InterstitialTech/automato-sensor/kicad/automato-jsts.png

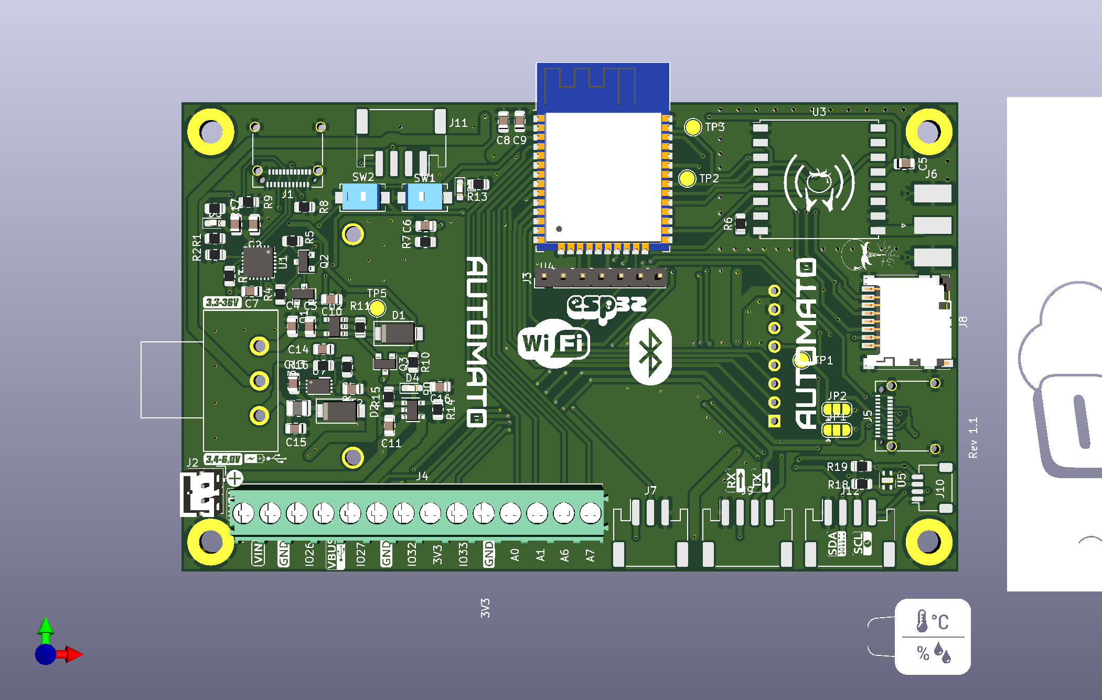
kicad/automato-jsts.png
