InterstitialTech/automato-sensor/README.md

# automato-sensor
sensor module for the Automato ecosystem

Schematic

PCB Layout

3D Rendering
