InterstitialTech/automato-sensor/kicad/automato.kicad_pcb

## KiCad design kicad/automato.kicad_pcb (2022-09-19)

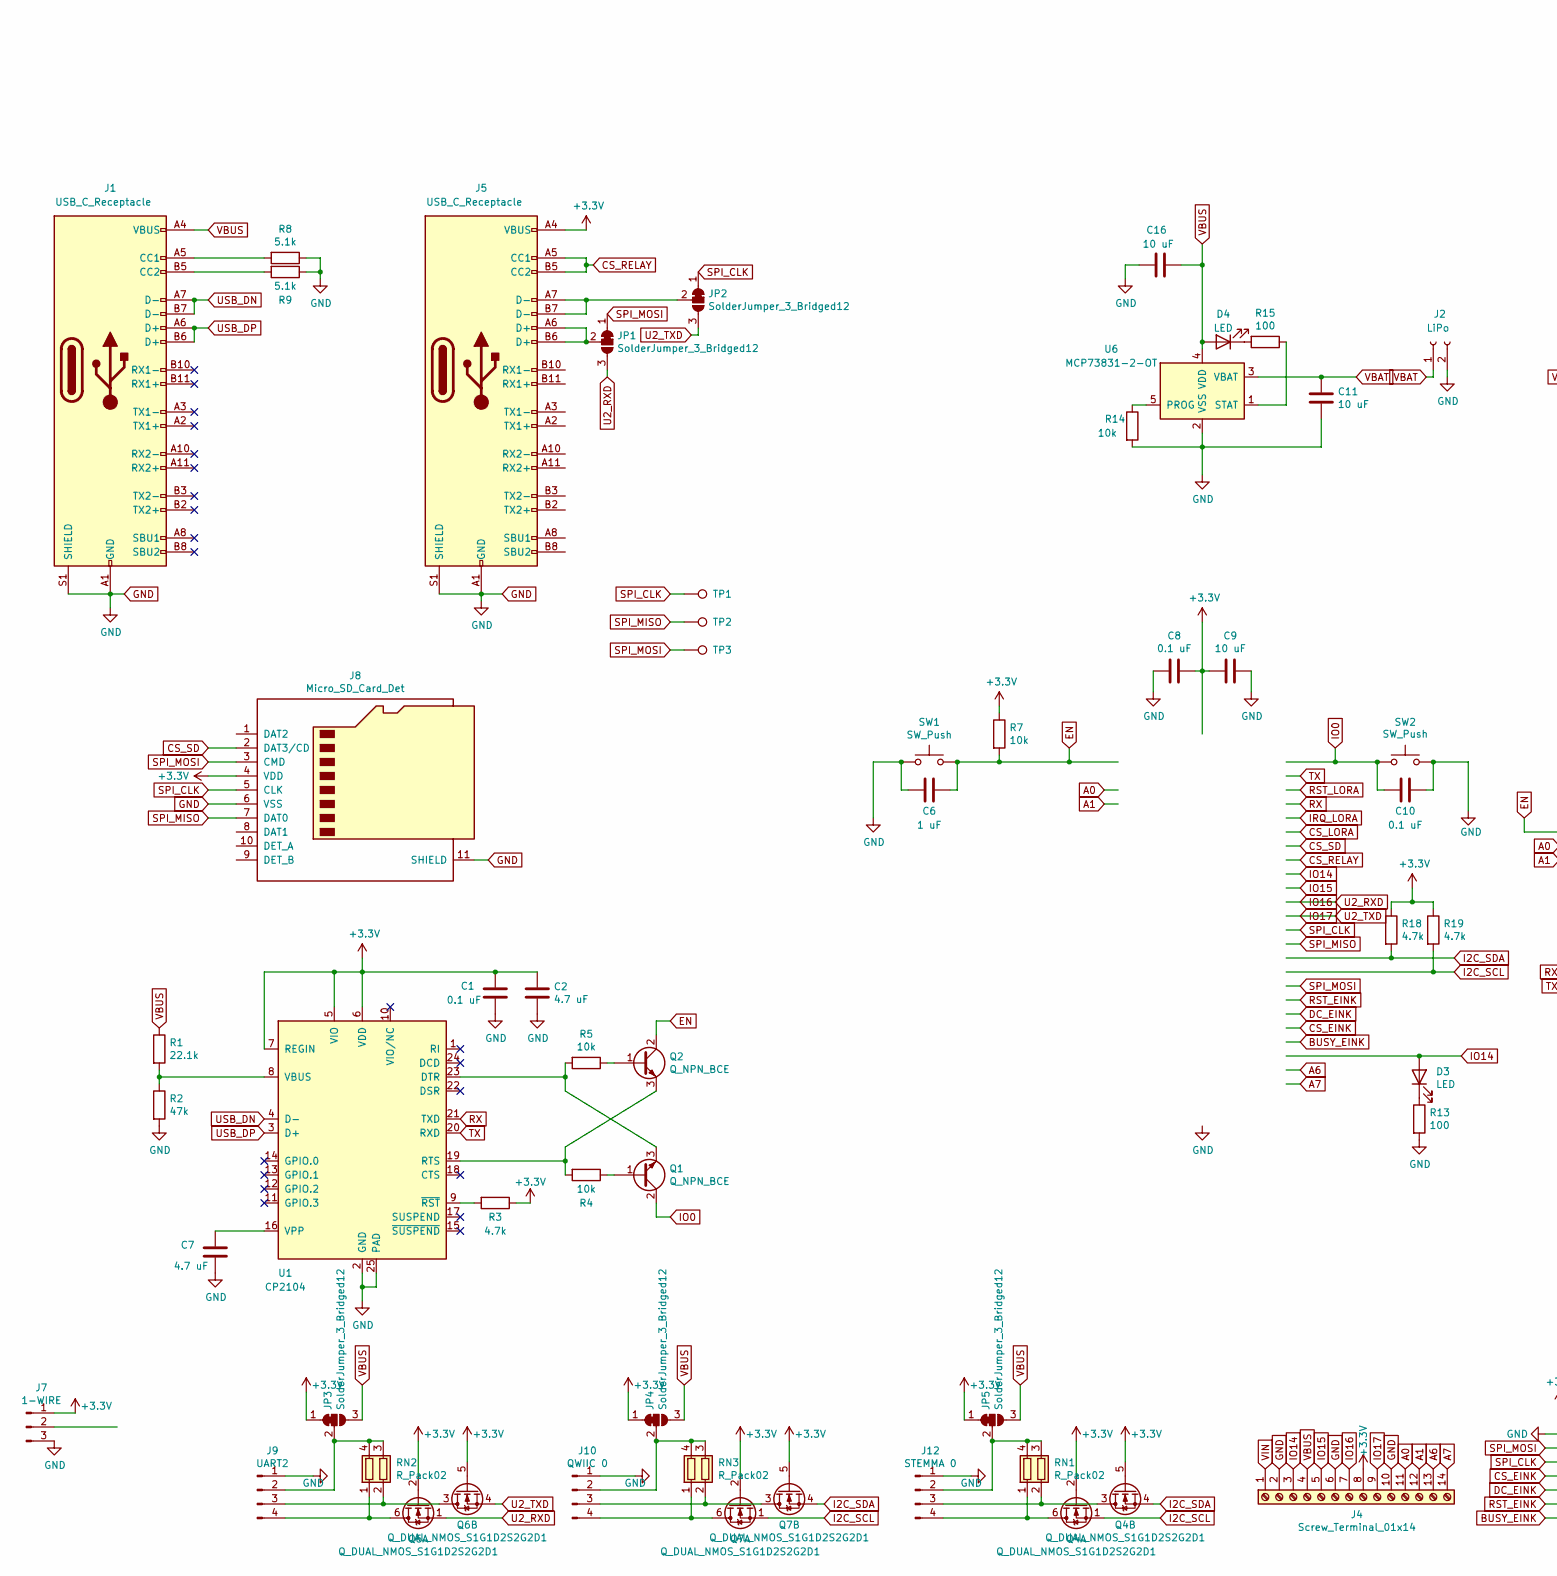
[picture p2: schematic automato.sch, Automato Sensor Board, part in row 1, column 1]

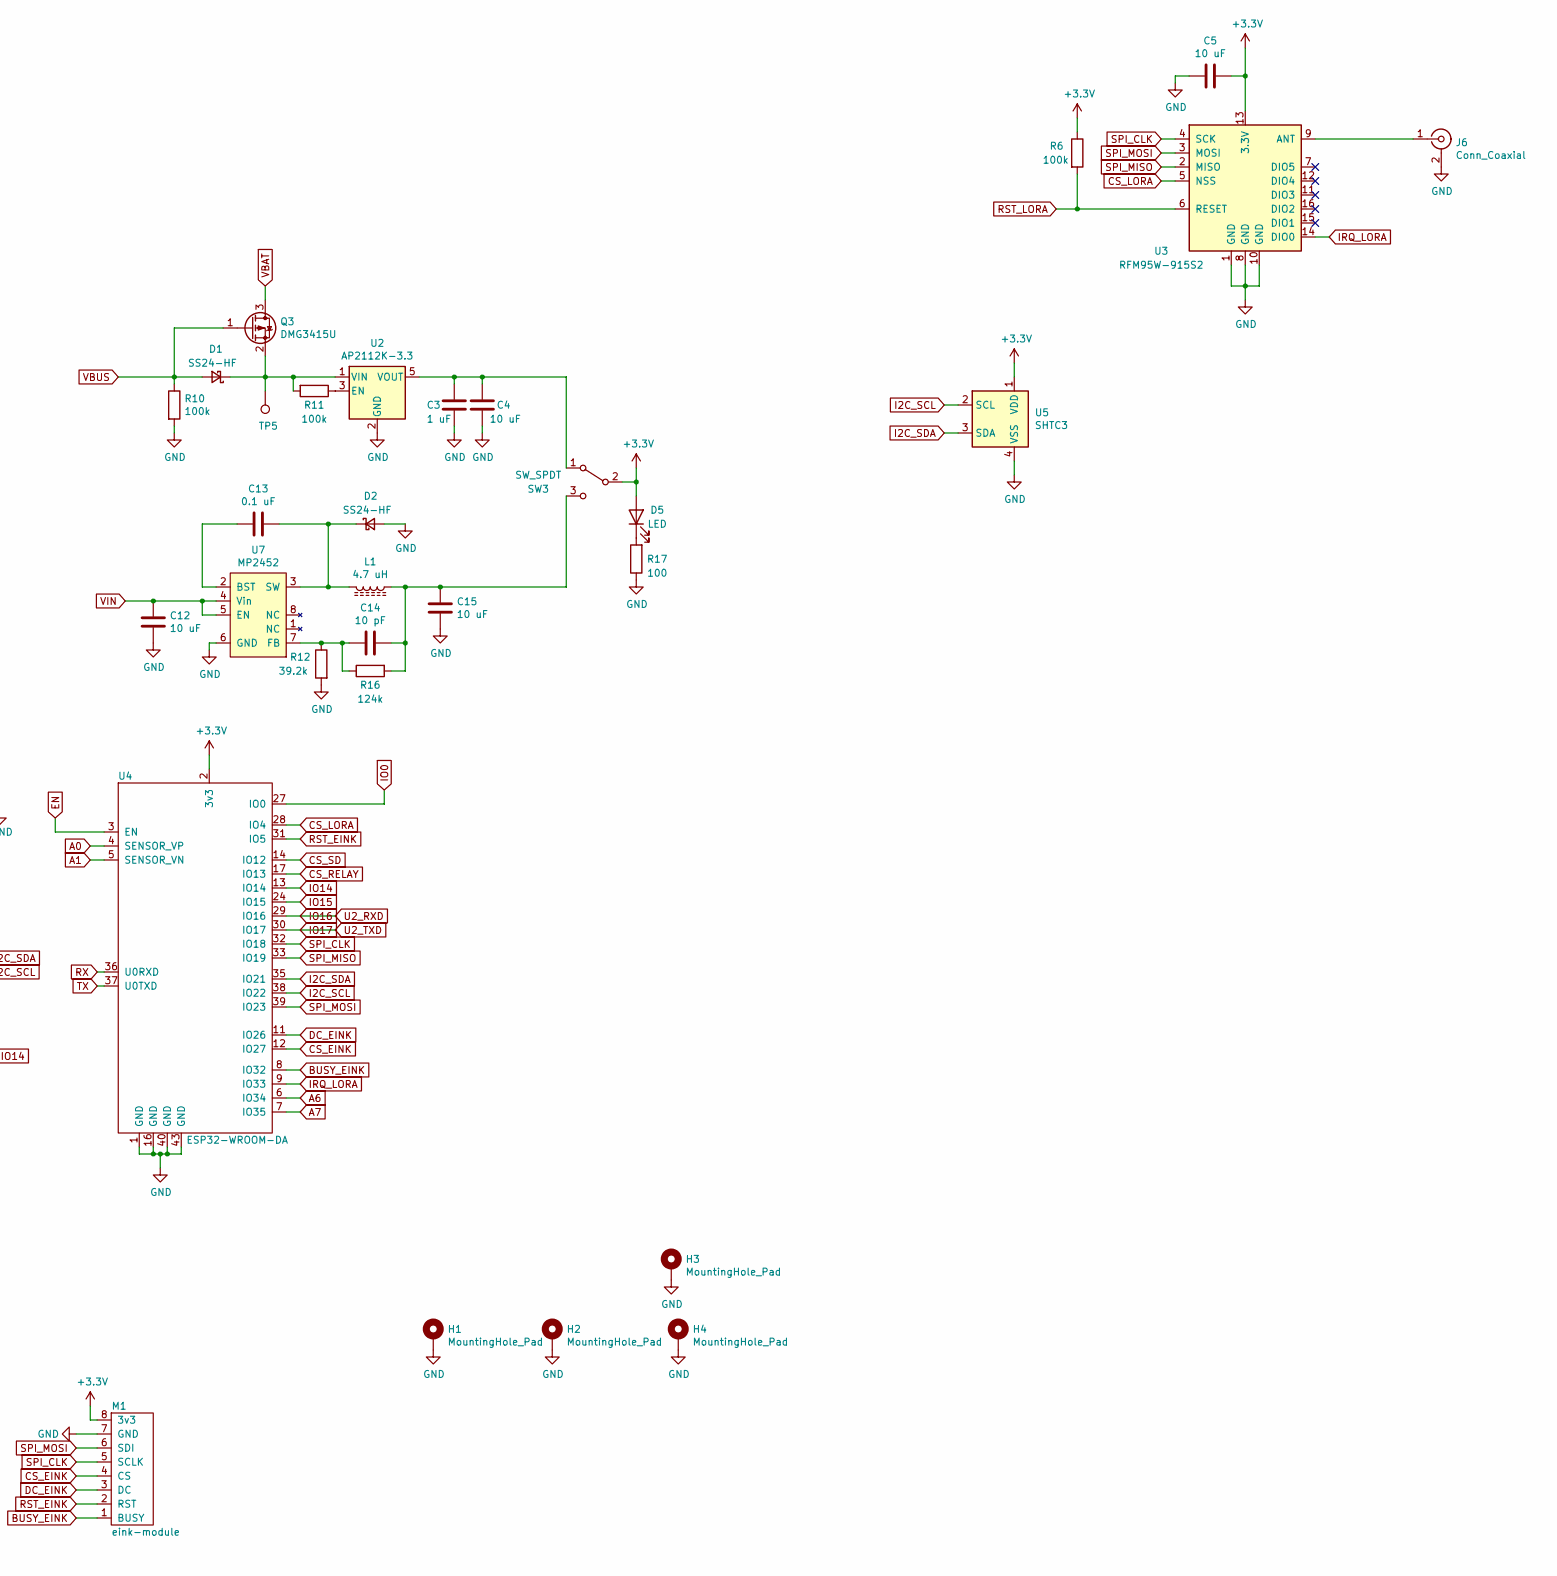
[picture p3: schematic automato.sch, Automato Sensor Board, part in row 1, column 2]

Parts:
C1, C8, C10, C13: 0.1 uF; C_0805_2012Metric
C2, C7: 4.7 uF; C_0805_2012Metric
C3, C6: 1 uF; C_0805_2012Metric
C4, C5, C9, C11, C12, C15, C16: 10 uF; C_0805_2012Metric
C14: 10 pF; C_0805_2012Metric
D1, D2: SS24-HF; D_SMA
D3, D4, D5: LED; LED_0603_1608Metric_Castellated
H1, H2, H3, H4: MountingHole_Pad; MountingHole_3.2mm_M3_Pad_TopBottom
J1, J5: USB_C_Receptacle; USB_C_Receptacle_Amphenol_12401610E4-2A_CircularHoles
J2: LiPo; JST_PH_B2B-PH-K_1x02_P2.00mm_Vertical
J4: Screw_Terminal_01x14; TerminalBlock_Phoenix_PT-1,5-14-3.5-H_1x14_P3.50mm_Horizont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
J6: Conn_Coaxial; SMA_Molex_73251-1153_EdgeMount_Horizontal
J7: 1-WIRE; JST_PH_S3B-PH-SM4-TB_1x03-1MP_P2.00mm_Horizontal
J8: Micro_SD_Card_Det; MEM2051-00-195-00-A
J9: UART2; JST_PH_S4B-PH-SM4-TB_1x04-1MP_P2.00mm_Horizontal
J10: QWIIC 0; JST_SH_SM04B-SRSS-TB_1x04-1MP_P1.00mm_Horizontal
J12: STEMMA 0; JST_PH_S4B-PH-SM4-TB_1x04-1MP_P2.00mm_Horizontal
JP1, JP2, JP3, JP4, JP5: SolderJumper_3_Bridged12; SolderJumper-3_P1.3mm_Bridged12_RoundedPad1.0x1.5mm
L1: 4.7 uH; L_1008_2520Metric
M1: eink-module
Q1, Q2: Q_NPN_BCE; SOT-23
Q3: DMG3415U; SOT-23
Q4, Q6, Q7: Q_DUAL_NMOS_S1G1D2S2G2D1; SOT-23-6
R1: 22.1k; R_0805_2012Metric
R2: 47k; R_0805_2012Metric
R3, R18, R19: 4.7k; R_0805_2012Metric
R4, R5, R7, R14: 10k; R_0805_2012Metric
R6, R10, R11: 100k; R_0805_2012Metric
R8, R9: 5.1k; R_0805_2012Metric
R12: 39.2k; R_0805_2012Metric
R13, R15, R17: 100; R_0805_2012Metric
R16: 124k; R_0805_2012Metric
RN1, RN2, RN3: R_Pack02; R_Array_Concave_2x0603
SW1, SW2: SW_Push; SW_SPST_EVQPE1
SW3: SW_SPDT; L102021ML04Q
TP1, TP2, TP3, TP5: TestPoint; TestPoint_Pad_D2.0mm
U1: CP2104; QFN-24-1EP_4x4mm_P0.5mm_EP2.6x2.6mm
U2: AP2112K-3.3; SOT-23-5
U3: RFM95W-915S2; HOPERF_RFM9XW_SMD
U4: ESP32-WROOM-DA
U5: SHTC3; Sensirion_DFN-4-1EP_2x2mm_P1mm_EP0.7x1.6mm
U6: MCP73831-2-OT; SOT-23-5
U7: MP2452; DFN-8-1EP_3x2mm_P0.5mm_EP1.75x1.45mm

Connections:
+3V3: C1.1, C2.1, C5.1, C8.1, C9.2, D5.2 (A), J4.8, J5.A4 (VBUS), J5.A9 (VBUS), J5.B4 (VBUS), J5.B9 (VBUS), J7.1, J8.4 (VDD), JP3.1 (A), JP4.1 (A), JP5.1 (A), M1.8 (3v3), Q4.2 (G), Q4.5 (G), Q6.2 (G), Q6.5 (G), Q7.2 (G), Q7.5 (G), R3.1, R6.1, R7.1, R18.1, R19.1, SW3.2 (B), U1.5 (VIO), U1.6 (VDD), U1.7 (REGIN), U3.13 (3.3V), U4.2 (3v3), U5.1 (VDD)
A0: J4.11, U4.4 (SENSOR_VP)
A1: J4.12, U4.5 (SENSOR_VN)
A6: J4.13, U4.6 (IO34)
A7: J4.14, U4.7 (IO35)
BUSY_EINK: M1.1 (BUSY), U4.8 (IO32)
CS_EINK: M1.4 (CS), U4.12 (IO27)
CS_LORA: U3.5 (NSS), U4.28 (IO4)
CS_RELAY: J5.A5 (CC1), J5.B5 (CC2), U4.17 (IO13)
CS_SD: J8.2 (DAT3/CD), U4.14 (IO12)
DC_EINK: M1.3 (DC), U4.11 (IO26)
EN: C6.1, Q2.2 (C), R7.2, SW1.2, U4.3 (EN)
GND: C1.2, C2.2, C3.2, C4.2, C5.2, C6.2, C7.2, C8.2, C9.1, C10.1, C11.2, C12.2, C15.2, C16.1, D2.2 (A), H1.1, H2.1, H3.1, H4.1, J1.A1 (GND), J1.A12 (GND), J1.B1 (GND), J1.B12 (GND), J1.S1 (SHIELD), J2.2, J4.2, J4.6, J4.10, J5.A1 (GND), J5.A12 (GND), J5.B1 (GND), J5.B12 (GND), J5.S1 (SHIELD), J6.2 (Ext), J7.3, J8.6 (VSS), J8.11 (SHIELD), J9.1, J10.1, J12.1, M1.7 (GND), R2.2, R8.1, R9.1, R10.2, R12.2, R13.2, R14.2, R17.1, SW1.1, SW2.2, U1.2 (GND), U1.25 (PAD), U2.2 (GND), U3.1 (GND), U3.8 (GND), U3.10 (GND), U4.1 (GND), U4.16 (GND), U4.40 (GND), U4.43 (GND), U5.4 (VSS), U6.2 (VSS), U7.6 (GND)
I2C_SCL: Q4.1 (S), Q7.1 (S), R19.2, U4.38 (IO22), U5.2 (SCL)
I2C_SDA: Q4.4 (S), Q7.4 (S), R18.2, U4.35 (IO21), U5.3 (SDA)
IO0: C10.2, Q1.2 (C), SW2.1, U4.27 (IO0)
IO14: D3.2 (A), J4.3, U4.13 (IO14)
IO15: J4.5, U4.24 (IO15)
IO16: J4.7, JP1.3 (B), Q6.1 (S), U4.29 (IO16)
IO17: J4.9, JP2.3 (B), Q6.4 (S), U4.30 (IO17)
IRQ_LORA: U3.14 (DIO0), U4.9 (IO33)
unnamed: C3.1, C4.1, SW3.1 (A), U2.5 (VOUT)
unnamed: C7.1, U1.16 (VPP)
unnamed: C13.1, D2.1 (K), L1.2, U7.3 (SW)
unnamed: C13.2, U7.2 (BST)
unnamed: C14.1, R12.1, R16.1, U7.7 (FB)
unnamed: C14.2, C15.1, L1.1, R16.2, SW3.3 (C)
unnamed: D1.1 (K), Q3.2 (S), R11.2, TP5.1, U2.1 (VIN)
unnamed: D3.1 (K), R13.1
unnamed: D4.1 (K), R15.2
unnamed: D5.1 (K), R17.2
unnamed: J1.A5 (CC1), R8.2
unnamed: J1.B5 (CC2), R9.2
unnamed: J5.A6 (D+), J5.B6 (D+), JP1.2 (C)
unnamed: J5.A7 (D-), J5.B7 (D-), JP2.2 (C)
unnamed: J6.1 (In), U3.9 (ANT)
unnamed: J9.2, JP3.2 (C), RN2.3 (R2.2), RN2.4 (R1.2)
unnamed: J9.3, Q6.3 (D), RN2.2 (R2.1)
unnamed: J9.4, Q6.6 (D), RN2.1 (R1.1)
unnamed: J10.2, JP4.2 (C), RN3.3 (R2.2), RN3.4 (R1.2)
unnamed: J10.3, Q7.3 (D), RN3.2 (R2.1)
unnamed: J10.4, Q7.6 (D), RN3.1 (R1.1)
unnamed: J12.2, JP5.2 (C), RN1.3 (R2.2), RN1.4 (R1.2)
unnamed: J12.3, Q4.3 (D), RN1.2 (R2.1)
unnamed: J12.4, Q4.6 (D), RN1.1 (R1.1)
unnamed: Q1.1 (B), R4.1
unnamed: Q1.3 (E), R5.2, U1.23 (DTR)
unnamed: Q2.1 (B), R5.1
unnamed: Q2.3 (E), R4.2, U1.19 (RTS)
unnamed: R1.2, R2.1, U1.8 (VBUS)
unnamed: R3.2, U1.9 (~RST)
unnamed: R11.1, U2.3 (EN)
unnamed: R14.1, U6.5 (PROG)
unnamed: R15.1, U6.1 (STAT)
RST_EINK: M1.2 (RST), U4.31 (IO5)
RST_LORA: R6.2, U3.6 (RESET)
RX: U1.21 (TXD), U4.36 (U0RXD)
SPI_CLK: J8.5 (CLK), JP2.1 (A), M1.5 (SCLK), TP1.1, U3.4 (SCK), U4.32 (IO18)
SPI_MISO: J8.7 (DAT0), TP2.1, U3.2 (MISO), U4.33 (IO19)
SPI_MOSI: J8.3 (CMD), JP1.1 (A), M1.6 (SDI), TP3.1, U3.3 (MOSI), U4.39 (IO23)
TX: U1.20 (RXD), U4.37 (U0TXD)
USB_DN: J1.A7 (D-), J1.B7 (D-), U1.4 (D-)
USB_DP: J1.A6 (D+), J1.B6 (D+), U1.3 (D+)
VBAT: C11.1, J2.1, Q3.3 (D), U6.3 (VBAT)
VBUS: C16.2, D1.2 (A), D4.2 (A), J1.A4 (VBUS), J1.A9 (VBUS), J1.B4 (VBUS), J1.B9 (VBUS), J4.4, JP3.3 (B), JP4.3 (B), JP5.3 (B), Q3.1 (G), R1.1, R10.1, U6.4 (VDD)
VIN: C12.1, J4.1, U7.4 (Vin), U7.5 (EN)

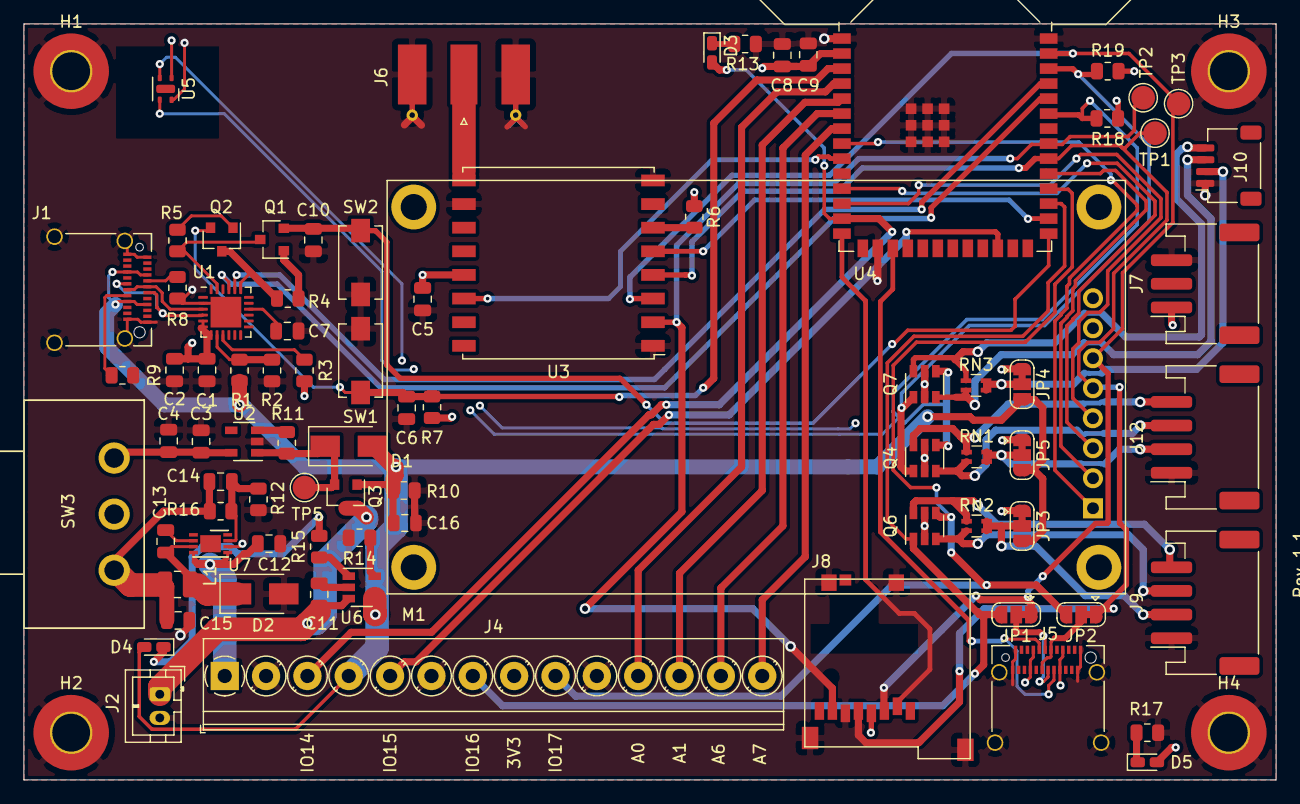
[picture p4: board automato.kicad_pcb from above]

Board: 4 copper layers, 106.0 x 64.0 mm, 84 parts (0 on the bottom side), 66 nets.
