InterstitialTech/automato-sensor/(commit log)

2020-12-08 add power indicator LED
    [automato.sch]
2020-12-08 add annotations
    [automato.sch]
2020-12-11 correct regulator part no: AP2112K-3.3
    [automato.sch]
2020-12-19 add (most) footprints
    [automato.sch]
2020-12-19 add bom.csv
    [bom.csv]
2020-12-19 add SHC3 temp/humidity sensor
    [automato.sch, bom.csv]
2020-12-20 add charge controller
    [automato.sch, bom.csv]
2020-12-22 Added boost and buck regulators
    I still need to add some logic to enable/disable these regulators based on input voltage level/use case. I'm guessing the easiest thing for rev1 would be to have two separate inputs for the boost and the buck?
    [automato.sch]
2020-12-26 remove boost converter, connect buck via SPDT
    [automato.sch]
2020-12-27 add analog pins: A0, A1, A6, A7
    [automato.sch]
2020-12-28 add footprints: L1, Q3, SW3, LEDs, etc
    [automato.sch, bom.csv]
2020-12-28 add ILI9431_2.8in library symbol and footprint
    [automato.sch]
2020-12-29 serialize designators, update Schottkys
    [automato.sch]
2020-12-29 set all LED resistors to 100 ohms
    [automato.sch, bom.csv]
2020-12-29 re-arrange schematic, update netlist
    [automato.sch]
2020-12-29 J2: set footprint to JST_PH_B2B-PH-K_1x02_P2.00mm_Vertical
    [automato.sch]
2020-12-29 fp-info-cache: resolve Sensor_Humidity footprint library
2020-12-29 Q3: fix pin numbering, update netlist
    [automato.sch]
2020-12-31 lay out components (no tracks yet)
    [automato.kicad_pcb, automato.sch]
2020-12-31 layout: route traces
    [automato.kicad_pcb]
2021-01-01 fill GND and power planes, adjust traces
    [automato.kicad_pcb]
2021-01-03 layout: taper off right angles
    [automato.kicad_pcb]
2021-01-03 update LED footprints to 0603 castellated
    [automato.kicad_pcb, automato.sch]
2021-01-15 consolidate C6 and C7
    [automato.kicad_pcb, automato.sch, bom.csv]
2021-01-15 ILI9341_2.8in: move outline from F.Mask to F.Silk
    [automato.kicad_pcb]
2021-01-15 layout: add mounting holes
    [automato.kicad_pcb]
2021-01-15 add I2C pull-ups
    [automato.kicad_pcb, automato.sch, bom.csv]
2021-01-15 add test points
    [automato.kicad_pcb, automato.sch]
2021-01-26 switch to CP2104 (schematic and BOM)
    [automato.sch, bom.csv]
2021-01-26 CP2104: update footprints and netlist
    [automato.sch]
2021-01-26 correct DP/DN mixup
    [automato.sch]
2021-01-26 CP2104: update layout
    [automato.kicad_pcb, automato.sch]
2021-01-28 layout: add back mounting holes
    [automato.kicad_pcb]
2021-01-31 add silkscreen contributions from John
    [automato.kicad_pcb]
2021-02-01 bom.csv: update U1 to CP2104
    [bom.csv]
2021-03-02 schematic: add metadata
    [automato.sch]
2021-03-02 .gitignore: add kicad/_autosave-*
2021-03-22 bom.csv: correct part number for C14
    [bom.csv]
2021-03-22 revert to library-standard USB-C receptacle for J1
    [automato.kicad_pcb, automato.sch]
2021-03-22 increase hole diameter on SW3 to 1.65 mm
    [automato.kicad_pcb]
2021-10-06 rescue symbols (kicad 5.1.10)
    [automato.sch]
2021-10-06 fix charge contoller support circuitry
    * R14: 5.1k -> 10k
    * C16: new 10 uF bypass capacitor for VBUS
    * update revision number to 1.1
    these changes intended to address the overheating problem
    with U6.
    [automato.kicad_pcb, automato.sch, bom.csv]
2022-06-07 add second usb c for serial
    [automato.sch]
2022-07-01 ground new usb-c connection
    [automato.kicad_pcb, automato.sch]
2022-07-01 start 3-row servo-style headers
    [automato.sch]
2022-07-01 add servo-style headers to pcb
    [automato.kicad_pcb]
2022-07-01 add footprints for headers
    [automato.sch]
2022-07-01 a bit of reshuffling
    [automato.kicad_pcb]
2022-07-01 signal routing for relay-board spi
    [automato.sch]
2022-07-10 add sd footprint, solder jumpers for optional usb-c uart
    [automato.kicad_pcb]
2022-07-10 add solder jumpers
    optional control of automato-relay with usb-c uart instead of usb-c spi.
    [automato.sch]
2022-07-12 change 2x15 header symbol
    [automato.sch]
2022-07-12 remove lcd
    [automato.sch]
2022-07-13 remove servo style gpio headers
    [automato.sch]
2022-07-13 update pcb
    [automato.kicad_pcb]
2022-07-13 moved battery charging circuit to clean up sch
    [automato.sch]
2022-07-13 remove lcd, clean up some traces
    [automato.kicad_pcb]
2022-07-13 wiring for sd card, still need card detect
    [automato.sch]
2022-07-21 add eink module to board
    [automato.kicad_pcb, automato.sch]
2022-07-21 updated pin assignments
    [automato.sch]
2022-07-21 starting route
    [automato.kicad_pcb]
2022-07-21 rearrange power and usb-serial
    [automato.kicad_pcb]
2022-07-21 swapped io pin names on screw terminal
    [automato.sch]
2022-07-21 improve sensor gpio screw terminal ordering
    [automato.sch]
2022-07-21 flip vbus and 3v3
    [automato.sch]
2022-07-24 add sma
    [automato.sch]
2022-07-24 more routing
    [automato.kicad_pcb]
2022-07-24 reposition lora
    [automato.kicad_pcb]
2022-07-24 swapped cs_sd and cs_relay pins
    [automato.sch]
2022-07-24 moved indicator led
    [automato.kicad_pcb]
2022-07-30 add qwiic, i2c, 1wire jst
    [automato.sch]
2022-07-30 move some display pins around, change relay usb-c power to 3v3
    [automato.sch]
2022-07-30 keep routing, add qwiic connectors, change layout to optimize for density and rf
    [automato.kicad_pcb]
2022-07-30 route gpoi's
    [automato.kicad_pcb]
2022-08-02 add stemma connectors
    [automato.sch]
2022-08-05 adding more jst connectors, moving pin assignments
    [automato.sch]
2022-08-05 add jst, re-route
    [automato.kicad_pcb]
2022-08-05 change tactile switch footprint
    [automato.sch]
2022-08-17 add more standoffs to eink module
2022-08-17 finish JST route
    [automato.kicad_pcb, automato.sch]
2022-08-18 remove usb-c uart JST
    [automato.kicad_pcb, automato.sch]
2022-08-18 rearrange - component placement
    [automato.kicad_pcb]
2022-08-18 add i2c and uart level shifting
    [automato.sch]
2022-08-18 temp-move lora to left side, add level shifting
    [automato.kicad_pcb]
2022-08-19 rearrange usb serial converter
    [automato.kicad_pcb]
2022-08-19 spaced out power supplies
    [automato.kicad_pcb, automato.sch]
2022-08-20 more route
    [automato.kicad_pcb]
2022-08-21 ADD esp32-wroom-da
2022-08-21 put mounting holes back
    [automato.kicad_pcb]
2022-08-25 writing in wroom-da
    [automato.kicad_pcb, automato.sch]
2022-08-25 playing with pins
    [automato.sch]
2022-09-07 swapping to wroom-da
    [automato.sch]
2022-09-07 swap in wroom-da, remove swd header
    [automato.kicad_pcb]
2022-09-07 finished routing
    [automato.kicad_pcb]
2022-09-08 update bom
    [bom.csv]
2022-09-19 add mounting hole pads
    [automato.sch]
2022-09-19 update wroom-da routing
    [automato.kicad_pcb]
2022-09-19 place mounting holes
    [automato.kicad_pcb]
2022-09-19 add new sd card
    [automato.kicad_pcb, automato.sch]
2022-09-19 finish bom
    [bom.csv]
